wobwob73/mkii_wardriver/README.md

# mkii_wardriver
Fully fleshed out hardware-based wardriving system.
