wobwob73/mkii_wardriver/MKII_handoff/hardware_reference/canvas.png

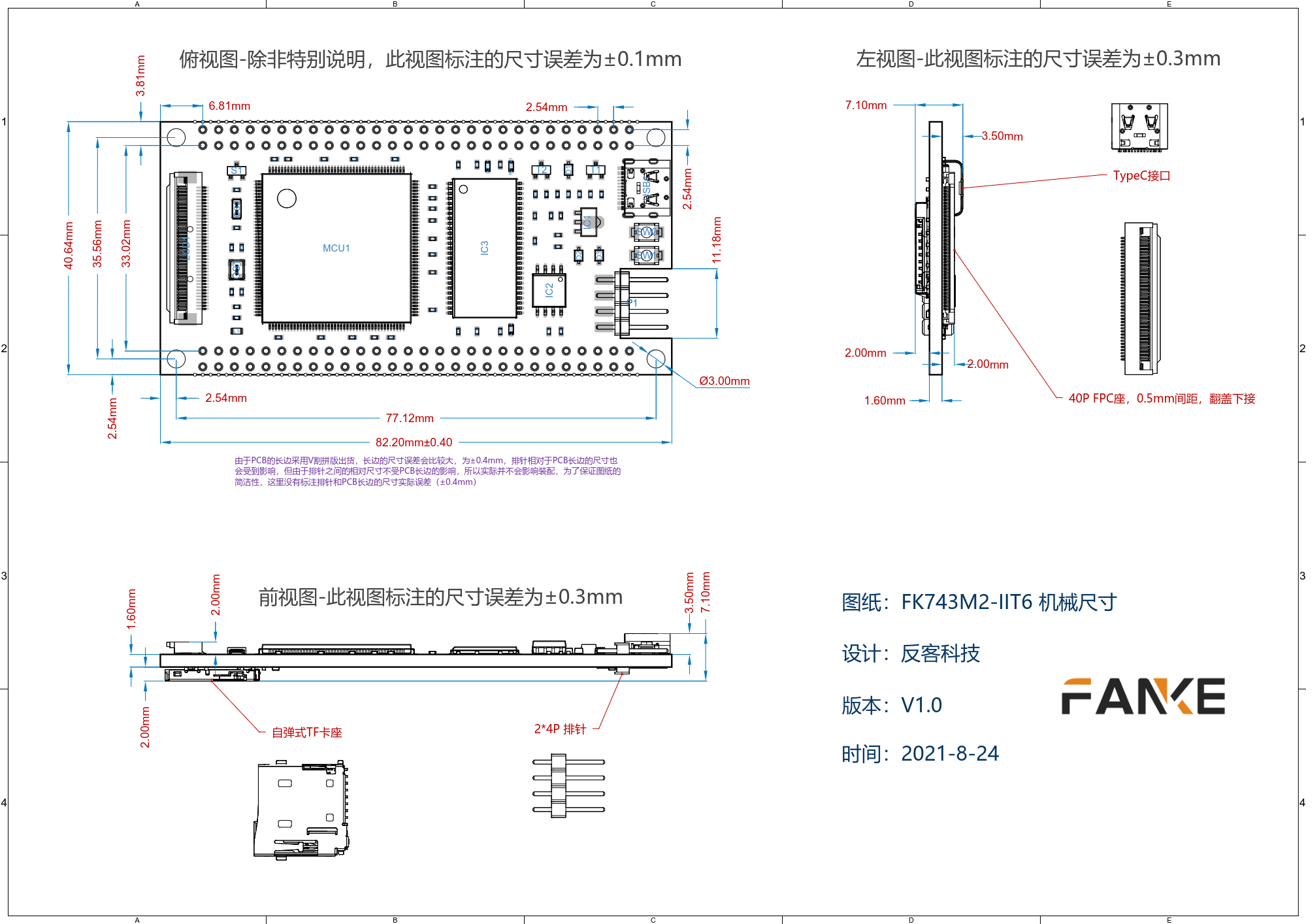
MKII_handoff/hardware_reference/canvas.png
