wobwob73/mkii_wardriver/firmware/agg_lite/src/pio_uart.h

#pragma once

#include "agg_defs.h"
#include "hardware/pio.h"

/* PIO software UART, reused verbatim from the WiFi BC (branch_wifi24). PIO0
 * SM0-SM2 carry the three Leaf RX links; a single PIO1 TX SM is retargeted per
 * send (F-001: PINCTRL OUT_BASE/SIDESET_BASE are updated and self-checked). */

typedef struct {
    PIO     pio;
    uint    sm;
    uint    rx_pin;
    int     dma_chan;
    uint32_t *ring;
    size_t  ring_words;
    volatile uint32_t read_pos;
} pio_uart_rx_t;

bool pio_uart_subsys_init(void);

bool pio_uart_rx_init(pio_uart_rx_t *u, uint pin, uint sm, uint32_t *ring, size_t ring_words);

int pio_uart_rx_read(pio_uart_rx_t *u, uint8_t *out, size_t cap);

void pio_uart_tx_send(uint pin, const uint8_t *bytes, size_t n);

void pio_uart_tx_send_line(uint pin, const char *line);

uint32_t pio_uart_tx_retarget_error_count(void);
