wobwob73/mkii_wardriver/(commit log)

2026-05-29 Add MKII handoff package (specs + docs)
    Extracted contents of 16523939-MKII_handoff.tar.gz as the project baseline:
    specs (system plan v2 + v2.1 amendment, WiFi24 leaf protocol v1.1, RP2040 BC
    guide v1.0, pre-MKII history), HANDOFF.md, CODE_STATUS.md, and FK743
    hardware reference (abandoned board, kept for lineage).
    No source code yet — the two prior firmware archives (leaf_wifi24,
    branch_wifi24) lived in an ephemeral sandbox and were not recoverable.
    Will be re-derived from the specs in subsequent commits.
2026-05-29 specs: add system_plan_v2_2_amendment (sensor-set reconciliation)
    Formalizes the SHT40 -> SCD41 + SGP41 change that HANDOFF.md flagged as
    stale in v2.1. Updates Sensor Branch §3.8 topology, sensor selection,
    core responsibilities, $EN (17 -> 20 fields, adds co2_ppm/voc_index/
    nox_index), $SB (replaces therm_ok with scd_ok + sgp_ok), failure
    handling, environment_records DDL, the Environment & Motion report row,
    and the cost estimate. Spec-first phase, item #1 from the roadmap.
2026-05-29 specs: add wifi24 BC firmware guide v1.1 amendment
    Resolves the four deviations CODE_STATUS.md flagged against BC v1.0:
    - §4.1 SPSC queues codified as true SPSC + __dmb() barriers (no
    spinlocks); §4.5 added with explicit producer/consumer pattern.
    - §6.3 dedup eviction switched from rehash-on-eviction to tombstone-
    based reclaim, with insert/lookup/compaction algorithms and a
    correctness sketch (fixes the double-increment bug).
    - §8.2 $RC relay now requires the embedded command's checksum to be
    re-verified before forwarding to a Leaf.
    - §12.1 PIO usage codified as PIO0 = 4× RX, PIO1 = 1× TX with OUT-pin
    remap per transmission; rationale documented.
    Also widens the `enc` fie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
2026-05-29 specs: add STM32 firmware guide v1.0 (NUCLEO-H753ZI)
    First-time spec for the STM32 mid-tier aggregator. Targets NUCLEO-
    H753ZI, supersedes the abandoned FK743M2-IIT6 design. Covers pin map
    for both STM32 units (single source tree via MKII_STM32_UNIT={1,2}
    flag), operating modes (standalone / connected / minimal), PPS edge
    capture + $TM emission within 100 ms, I2C GPS read (NMEA + UBX),
    Branch UART DMA RX + line dispatch, USB CDC streaming, $RC leaf_id
    routing, FatFS SD logging, module decomposition, state machine,
    memory budget, and bench-test procedure.
    Resolves HANDOFF.md §9 item 1 (STM32 board change). Spec-first phase,
    item #4 from the roadmap.
2026-05-29 specs: add Env Sensor Branch firmware guide v1.0 (RP2040)
    Single-board Branch (no Leaves). Covers I2C0 bus with ICM-42688-P,
    LIS3MDL, BMP390, SCD41, SGP41; dual-core split (Core 0 Madgwick AHRS
    @100 Hz, Core 1 slow sensors + output); per-sensor init/read details
    and conversions; SGP41 conditioning and SCD41-compensation chain;
    1PPS sync via the same pattern as the WiFi24 BC; $EN @10 Hz with the
    20-field v2.2 layout; $SB @0.1 Hz; module decomposition; memory
    budget; pico-sdk build config; bench-test procedure.
    Spec-first phase, item #5 from the roadmap.
2026-05-29 specs: add 5 GHz WiFi Branch v1.0 (Leaf protocol + BC firmware)
    Combined Leaf-protocol + BC-firmware doc for the 5 GHz WiFi Branch
    (ESP32-C5 ×2-3 + RP2040). Written as deltas against WiFi24 v1.1 + v1.2
    amendment and BC v1.0 + v1.1 amendment to avoid duplication; only the
    band-specific differences are restated. Covers the 5 GHz channel map
    (UNII-1/2A/2C/3), per-Leaf channel-set assignments, $CF channel_set_id
    table, 32-bit $CH bitmask split into lo/hi fields, $WA/$WP/$ET/$DF/$BS
    with branch_id W5G, ESP-IDF v5.x C5 specifics (passive scan, band
    selection), memory budget, and bench-test cadence expectations.
    Spec-first phase, item #6 from the roadmap.
2026-05-29 specs: add BLE/BT Branch v1.0 (Leaf protocol + BC firmware)
    Combined Leaf-protocol + BC-firmware doc for the BLE/BT Branch (2x
    ESP32-S3 + RP2040). BLE Leaf uses NimBLE with BLE 5 ext-adv + Coded
    PHY in BLE_SCAN_TYPE_PASSIVE; BT Classic Leaf uses Bluedroid in
    strict inquiry-scan mode (no active inquiry, per HANDOFF.md §1
    passive-only design). Defines $BL primary, $BX extended-payload
    follow-up, $BT BT Classic, $BK, and BC upstream $BD/$BX/$BC_T/$BS
    with branch_id BLE. Two dedup tables (5s BLE / 30s BT). Documents
    the listen-only caveats for BT Classic detection coverage. RPA
    resolution explicitly deferred to the analyzer.
    Spec-first phase, item #7 from the roadmap.
2026-05-29 specs: add 802.15.4 Branch v1.0 (Leaf protocol + BC firmware)
    Combined Leaf-protocol + BC-firmware doc for the 802.15.4 Branch
    (ESP32-H2 x2-4 + RP2040). Covers channels 11-26, ESP-IDF ieee802154
    component, promiscuous full-frame capture, MAC FCF parsing, addr-mode
    handling (short / extended), $ZD device records (14 fields incl. a
    proto_hint heuristic for Thread MLE / Zigbee NWK / Matter), $ZB beacon
    records with coordinator + SF spec + beacon payload, $CF with channel-
    set IDs 1-7, 16-bit $CH mask, BC dedup_dev (5s) + dedup_bcn (30s),
    $ZA / $ZN / $BS upstream with branch_id DOT. No WIDS path in v1.0.
    Spec-first phase, item #8 from the roadmap.
2026-05-29 specs: add Meshtastic/Meshcore Branch v1.0
    Combined Leaf-protocol + BC-firmware doc for the Meshtastic/Meshcore
    Branch (5x Heltec LoRa 32 V3 + RP2040 on STM32 #2 USART1). Extends
    the BC v1.1 PIO pattern: PIO0 holds 4 RX SMs, PIO1 hosts both the
    shared TX SM (SM0, OUT-pin remap) and a 5th RX SM (SM1). Per-Leaf
    default presets: MESH-1/2 US 915 (LongFast/MediumFast), MESH-3 EU 868,
    MESH-4 US 433, MCORE-1 915 Meshcore. SX1262 driven by RadioLib in
    listen-only continuous RX. $LR per packet with header_hex + proto_hint
    heuristic for Meshtastic / Meshcore / LoRaWAN / ELRS / Crossfire.
    BC dedups by (proto, node_id) over 60 s; $LA / $BS upstream with
    branch_id MTC. No intra-Leaf dedup (packets sparse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
2026-05-29 specs: add VHF ISM 315/433 MHz Branch v1.0
    Combined Leaf-protocol + BC-firmware doc for the VHF ISM Branch (6x
    Arduino Nano + superhet ASK RX modules + RP2040 on STM32 #2 USART2).
    Extends the BC PIO pattern further: PIO0 holds 4 RX SMs, PIO1 hosts
    the shared TX SM + 2 RX SMs = 6 Leaves total. Per-Leaf decoder
    profiles: 315-A/B Chamberlain/garage, 315-R generic ASK logger, 433-
    A/B rc-switch + Acurite + LaCrosse, 433-R generic. INT0-driven edge
    ring buffer (256 entries), rc-switch + custom decoders, repeat-count
    accumulator. $SG per detection w/ 11 fields incl. raw_code_hex,
    protocol_id heuristic, extra_hex for sensor payloads. BC dedups by
    (protocol_id, raw_code) across all Leaves over 5s; $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
2026-05-29 specs: add UHF ISM 868/915 MHz Branch v1.0
    Combined Leaf-protocol + BC-firmware doc for the UHF ISM Branch.
    Most heterogeneous Branch yet: 8 Leaves spanning HaLow (HT-HC33),
    LoRa (SX1262 x4), and FSK (CC1101 x3). First Branch to exceed PIO
    SM capacity - introduces the canonical 8-Leaf BC layout: PIO0 +
    PIO1 host 7 RX SMs + 1 TX SM, and the 8th Leaf is wired to RP2040
    hardware UART1 (PL011). Three upstream message types - $HA HaLow,
    $LR LoRa (extends Meshtastic's), $FS FSK with sync-word + proto_hint
    covering Z-Wave / Sidewalk / EnOcean / KNX-RF. UAS detection on
    UHF-915-UAS via ELRS-distinctive SF6/BW500 + SF9/BW500 LoRa combos.
    Three dedup tables (one per protocol family), $HW / $LA / $FA /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
2026-05-29 specs: add FPV Detection Branch v1.0
    Combined Leaf-protocol + BC-firmware doc for the FPV Detection Branch
    (2x Nano + RX5808 5.8 GHz scanners, 1x ESP32-S3 + SX1280 ELRS 2.4 GHz
    C2, 1x Nano + SX1262 legacy 433 C2, + RP2040 on STM32 #2 UART5). RX5808
    in SPI mode (RotorHazard-compatible) sweeping the full 48-channel FPV
    map (Boscam A/B/E + Fatshark + Raceband + Lowband). $FV per active
    channel; BC's agg_video tracks per-channel state with new/dropped/
    periodic events; $VA upstream surfaces channel activity + a uas_hint
    coincidence flag when FPV video + LoRa C2 co-occur (v1.0 coarse - real
    DOA correlation deferred). SX1280 ELRS preset rotation (SF5/BW800
    500Hz, SF5/BW400 250Hz, SF6/BW400 150Hz,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
2026-05-29 fw: re-derive leaf_wifi24 firmware (ESP32-C3, v1.2.0)
    Single-binary Leaf firmware for all four WiFi 2.4 GHz Leaves. Identity
    adopted from first $CF on UART0 (Branch Controller link). Implements
    wifi24_leaf_protocol v1.1 + v1.2 amendment:
    - enc enum 0-10 incl. LE_OWE (9) and LE_WPA3_ENT (10); SDK auth-mode
    mapping + RSN AKM walker with MFP-based WPA3-Ent disambiguation.
    - Passive scan @ ~200 ms/channel for W1-W3 ($AP + $BK per cycle).
    - WIDS promiscuous mode for W4: 14-channel hop, 100 ms dwell, ring
    buffer drop-newest on overflow, FNV-1a per-cycle BSSID dedup (512
    slots), $BC / $DE / $PR emission from main loop drain.
    - Standalone fallback after 10 s with no $CF (scan ch 1, leaf_id W?)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
2026-05-29 fw: re-derive branch_wifi24 firmware (RP2040, v1.1.0)
    WiFi 2.4 GHz Branch Controller firmware. Dual-core: Core 0 services
    four PIO0 RX state machines + line assembly + per-Leaf watchdog +
    downstream $CF/$CH/$PG/$RB; Core 1 owns 1PPS ISR + $TM ingest from
    STM32 UART0 + AP dedup + WIDS analysis + upstream $WA/$WP/$ET/$DF/$BS.
    Implements branch_controller_wifi24 v1.0 + v1.1 amendment:
    - True SPSC inter-core queues with __dmb() barriers, no spinlocks
    (queues.c).
    - PIO0 = 4 RX SMs loaded with uart_rx.pio; PIO1 = 1 TX SM with OUT-
    pin remap to address any of the four Leaves (pio_uart.c +
    uart_tx.pio).
    - Tombstone-based dedup eviction with linear-probe insert/lookup that
    records the first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
2026-05-29 ci: add GitHub Actions builds for leaf_wifi24 and branch_wifi24
    PlatformIO build for the ESP32-C3 Leaf firmware and pico-sdk + Ninja
    build for the RP2040 Branch Controller firmware. Both upload elf +
    bin/uf2 as workflow artifacts and key their caches off the
    platformio.ini / pico-sdk tag so subsequent runs are fast.
    Triggers on push and PR for changes under the respective firmware tree
    or the workflow file itself, plus manual workflow_dispatch. Adds the
    infrastructure called for in the spec-first phase's CI decision.
2026-05-29 fw(branch_wifi24): fix build - replace 'uint' with 'unsigned int'
    Local smoke build with pico-sdk 2.1.0 + arm-none-eabi-gcc 13.2.1
    revealed two issues in headers used by C compilation units:
    - 'uint' is a pico-sdk typedef in <pico/types.h>, not a standard C
    type. Header files (pps_time.h, leaf_cmd.h) used it in function
    signatures before pulling in the SDK header, so a compilation unit
    including just the local header before the SDK was including any
    pico-sdk header failed with 'unknown type name uint'. Switched to
    'unsigned int' which is the underlying definition.
    - main.c calls set_sys_clock_khz() which lives in hardware/clocks.h;
    the implicit-declaration warning is now resolve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
    [leaf_cmd.c, leaf_cmd.h, main.c, pps_time.c, pps_time.h]
2026-05-29 fw: add stm32_aggregator (App/ + PAL + Core/ scaffold)
    NUCLEO-H753ZI firmware. Single source tree, two unit images via
    -DMKII_STM32_UNIT={1,2} (unit 1 = WiFi24/W5G/BLE/DOT154/SEN on
    USART1/2/UART4/5/USART6; unit 2 = MTC/VHF/UHF/FPV on USART1/2/UART4/5).
    Structured around a Platform Abstraction Layer (Platform/Inc/pal.h)
    so the App/ business logic is portable C and the HAL specifics live
    in pal_hal.c. The PAL implementation is a stub - filling it in
    against CubeMX-generated HAL handles is described step-by-step in
    README.md "HAL bring-up".
    App/ modules (all spec-conformant per stm32_h753_firmware_v1_0.md):
    - proto: $..*XX\n framing + checksum + line receiver (shared shape
    with BC/Leaf pro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
2026-05-29 fw: add env_sensor_branch firmware (RP2040, v1.0.0)
    Single-board Branch (no Leaves). Implements env_sensor_branch_v1_0.md.
    Dual-core: Core 0 runs IMU @ 100 Hz + Madgwick AHRS + push to SPSC ring
    at 10 Hz; Core 1 services slow sensors (BMP390 @ 10 Hz, SCD41 @ 0.2 Hz,
    SGP41 @ ~1 Hz with conditioning), $TM ingest from STM32 UART0, $EN
    emission at 10 Hz with the v2.2-amended 20-field layout, $SB at 0.1 Hz.
    Sensor drivers (drop-in placement on shared I2C0 @ 400 kHz):
    - icm42688: WHO_AM_I check, ±8 g / ±2000 dps, INT1 push-pull pulsed,
    14-byte temp+accel+gyro burst read with SI conversion.
    - lis3mdl: WHO_AM_I check, ultra-high-perf XY/Z, ±4 gauss, continuous,
    6-byte XYZ read auto-increment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
2026-05-29 fw: add 5 GHz WiFi Branch (leaf_wifi5 + branch_wifi5)
    Implements wifi5_branch_v1_0.md.
    leaf_wifi5 (ESP32-C5, Arduino/PlatformIO, ~750 lines):
    - Single-binary, identity from first $CF on UART0. W5_1 / W5_2 / W5_3.
    - esp_wifi_set_band(WIFI_BAND_5G) at boot for both scan and WIDS paths.
    - $CF carries (mode, channel_set_id, dwell_ms): channel_set_id 1-7 maps
    to UNII band combinations per the spec. Default per-Leaf assignments:
    W5_1 csid=3 (UNII-1+2A), W5_2 csid=6 (UNII-2C+3), W5_3 csid=7 (all).
    - Scan path hops across the channel-set list with passive scan ~200 ms/
    channel; emits $AP + $BK each batch (sweep times ~1.6 s / 3.4 s / -).
    - WIDS path identical to leaf_wifi24's $BC/$DE/$PR + ri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
2026-05-29 fw(leaf_wifi5): switch to pioarduino platform for ESP32-C5 support
    CI run 26661010736 failed leaf_wifi5 at ~16 s — mainline PlatformIO
    espressif32@^6.9.0 doesn't recognize esp32-c5-devkitc-1 yet (the
    platform tracks arduino-esp32 with a multi-month lag; C5 support
    reached arduino-esp32 in 3.1.x but hasn't propagated to the registry
    package this firmware was pinned to).
    pioarduino is the community-maintained PlatformIO platform fork that
    ships current arduino-esp32 releases — including a board file for
    esp32-c5-devkitc-1 and arduino-esp32 v3.x. Pinning to a specific
    release (54.03.21) keeps the build reproducible.
    Addresses wifi5_branch_v1_0.md Open Item #2.
2026-05-29 fw(leaf_wifi5): correct pioarduino platform URL (tag 55.03.38-1)
    The previous attempt pointed at a release-asset zip URL that doesn't
    exist - pioarduino's tag scheme is 55.03.xx (not 54.03.xx) and the
    release asset filename varies per release.
    Switching to PlatformIO's git+tag URL form which resolves to the
    tagged commit and always works for any pioarduino release. Pinned to
    55.03.38-1, the latest stable as of this commit, which ships
    arduino-esp32 v3.3.x and includes an esp32-c5-devkitc-1 board file.
    Re-kicks CI run that failed on 1414303 with the same "build" error.
2026-05-30 fw(stm32): add HAL bring-up scaffold (Core/ + HAL-backed PAL)
    Hand-coded CubeMX-equivalent for the NUCLEO-H753ZI on-target build.
    Host-smoke build is unchanged (Platform/Src/pal_hal.c stays as stub);
    the on-target CMake target (added in a follow-up commit) compiles the
    new files instead.
    Added files:
    - Core/Inc/main.h: pin map (USART1/2/3/4/5/6/7, I2C1, SDMMC1, USB,
    EXTI10, LEDs, button), HAL handle externs, Branch RX ring decls.
    - Core/Inc/stm32h7xx_hal_conf.h: HAL module enables, HSE = 8 MHz from
    ST-LINK MCO bypass, voltage scale 0 (480 MHz), full HAL includes.
    - Core/Src/main.c: SystemClock_Config to 480/240/100 MHz, MX_*_Init
    for each peripheral, DMA RX circular start for the 4-5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
2026-05-30 fw(stm32): add on-target build — flashable .elf for both units
    Completes the STM32 firmware to a flashable image. The CMake
    on-target target (MKII_STM32_TARGET=on with the ARM bare-metal
    toolchain file) fetches STM32CubeH7 v1.11.2 via FetchContent, inits
    the HAL Drivers + CMSIS device submodules, builds the App/ + Core/ +
    Platform/ tree against the HAL, and produces stm32_aggregator_unit{1,
    2}.{elf,bin,hex} (~82 KB each).
    Added:
    - Platform/USB/Inc, Platform/USB/Src: USB CDC class glue
    (usb_device, usbd_conf, usbd_desc, usbd_cdc_if). FS speed, vendor
    0x1209, product 0x4D49 placeholder, per-unit serial string. Vendor
    hpcd PCD callbacks bridge to USBD core; CDC_Receive_FS pushes
    inbo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
2026-06-01 fw+docs: stabilize firmware trees; fix confirmed defects; truth-up handoff
    Stabilization pass across the existing firmware. No new branch firmware.
    Fixes confirmed defects, resolves two open decisions, and regenerates the
    status docs to match the repo. Verified by builds where the toolchain is
    reachable; the one network-gated build is documented.
    leaf_wifi5 — 5 GHz band-select bug (fixed; FW 1.0.0 -> 1.0.1)
    wifi_scan.cpp / wids_monitor.cpp guarded esp_wifi_set_band(WIFI_BAND_5G)
    with #ifdef WIFI_BAND_5G. WIFI_BAND_5G is an esp-idf wifi_band_t
    enumerator, not a macro, so the guard was always false and the call was
    compiled out — the C5 never left 2.4 GHz. Guards now use #ifdef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
    [leaf_defs.h, main.c, pal_hal.c, stm32_config.h, wids_monitor.cpp, wifi_scan.cpp]
2026-06-02 fw+specs: address external code review (mkii_code_analysis_report.md)
    Confirmed defects from the 2026-06-01 review fixed before any bring-up.
    No new branch firmware. Shared patterns fixed in place so the remaining
    six branches inherit a correct template.
    CRITICAL fixes
    F-001 — PIO TX retarget actually retargets (branch_wifi24, branch_wifi5).
    Old uart_tx_program_retarget_pin() only re-pinned the GPIO and never
    updated PINCTRL.OUT_BASE / SIDESET_BASE — every downstream byte left
    on the first leaf's TX pin, so W2..W4 / W5_2..W5_3 silently never
    received their $CF. New uart_tx_retarget_pin() in pio_uart.c:
    1. drain FIFO + 80 µs settle for the in-flight character;
    2. disabl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
    [branch_defs.h, cmd_router.c, core1_upstream.c, env_defs.h, gps.c, leaf_defs.h, pal_hal_stm32h7.c, pio_uart.c]
2026-06-02 fw(leaves): validate $CF mode at the boundary (review #4 pulled forward)
    Pull-forward of the second external review's finding #4 — the one item
    whose risk profile actually changed because of the previous push (F-001).
    Before F-001's PIO TX retarget fix, $CF to W2..W4 / W5_2..W5_3 wasn't
    reaching them; an unvalidated mode byte couldn't put a leaf into an
    unexpected state. With F-001 landed, $CF now reaches every leaf, and a
    corrupt mode byte (or a future $CF extension adding a value not yet
    enumerated) could flip a leaf into WIDS mode unexpectedly.
    Fix
    Reject mode values outside the declared LeafMode enum at the
    adopt_from_cf() boundary in both leaf trees. The existing
    hb::note_error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
    [config.cpp, leaf_defs.h]
2026-06-02 Add agg_lite light-duty aggregator, leaf_ble, and WiFi24 Scan-Hop (v1.3)
    Adds a single-box "lite" variant of the MKII aggregator for fixed-position
    use, plus the Leaf-side prerequisites it consumes, tied into the existing
    firmware/ trees and CI.
    firmware/agg_lite (NEW, RP2040, lite_aggregator_v1_0.md):
    - One RP2040 plays the Branch-Controller role for three families (2.4 GHz
    scan-hop, 5 GHz scan, BLE) and the STM32 role (own GPS, own 1PPS+$TM, SD).
    - Core 0: 3 PIO UART Leaf links, line assembly, per-family dispatch, health
    watchdog, downstream $CF/$CH/$PG/$RB. Core 1: GPS NMEA (UART1, F-003),
    1PPS + locally generated $TM (F-004 atomic snapshot), three dedup pipelines
    (WiFi re-entran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
    [agg_defs.h, agg_state.c, agg_state.h, ble_defs.h, ble_scan.c, ble_scan.h, cmd_handler.cpp, config.c]
2026-06-02 fw(leaf_ble): bound $BX fields so the framed line fits MAX_LINE_LEN
    ESP-IDF builds the component with -Werror=format-truncation, which caught a
    real defect: emit_bx() could produce a $BX line up to ~218 bytes, past the
    200-byte protocol limit (MAX_LINE_LEN). A longer line is truncated and its
    XOR checksum no longer matches, so the receiver drops it.
    Bound each field to its blebt_branch_v1_0.md §4.2 size: manufacturer data
    <=30 bytes (<=60 hex), service-UUID list capped at 16 bytes, and name_full_hex
    now carries only the bytes BEYOND the 16 already sent in $BL (per the spec,
    "Full local name beyond 16 bytes") instead of the whole name. Worst-case body
    is now ~154 bytes, well inside the limi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
    [main.c]
2026-06-02 fw(leaf_ble): bound combined $BX so the upstream record fits MAX_LINE_LEN
    The binding line is the aggregator/BC $BX, which prepends branch_id +
    timestamp + time_flag (~49 B) to the leaf's three variable fields. The prior
    per-field caps (60+32+32 hex) made the leaf line fit but pushed the upstream
    $BX to ~206 B, past MAX_LINE_LEN — where send_framed would drop it. The leaf
    also capped svc below what it had stored, silently dropping UUIDs.
    Cap the COMBINED manuf + svc + name hex to <=140 (manuf <=30 B, svc <=24 B on
    whole 2-byte UUID boundaries, name <=16 B beyond the 16 already in $BL), so the
    upstream $BX body is <=189 B and the line stays within MAX_LINE_LEN with a
    valid checksum. Any tr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
    [ble_defs.h, ble_scan.c, main.c]
2026-06-02 agg_lite: vendor FatFs-over-SPI library and implement the real SD backend
    Retires the SD placeholder as the durable path. Adds a real microSD backend
    behind the unchanged sd_spi_fatfs.h interface, selected with
    -DAGG_SD_BACKEND=fatfs; the stub stays selectable (default) for host/CI without
    a card.
    Vendoring (third_party/pico_fatfs_spi/):
    - carlk3 no-OS-FatFS-SD-SPI-RPi-Pico, pinned commit
    196016f525e5b9c161f2b965ddd3045a4ef87649 (master), Apache-2.0.
    - Vendored verbatim (FatFs_SPI/ library subtree + LICENSE); provenance in
    VENDOR.md. Tree unmodified; the FatFs ffconf.h is used as shipped
    (FF_FS_MINIMIZE=0 gives f_mkdir/f_rename; FF_USE_LFN=3 gives the 15-char
    YYYYMMDD_HHMMSS session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
2026-06-02 fw(agg_lite): fix premature comment close in sd_hw_config.c
    The header comment contained the glob "spi_get_*/sd_get_*", whose "*/" closed
    the block comment early, so the rest of the comment was parsed as C and the
    fatfs build failed (unknown type 'sd_get_', cascading int8_t errors). Reworded
    to remove the "*/" sequence. The vendored FatFs library and the real backend
    (sd_spi_fatfs.c) compiled fine; only this comment was at fault.
    https://claude.ai/code/session_01Fjuy4NfjJUpCQ34gpywTtY
    [sd_hw_config.c]
2026-06-02 fw(agg_lite): initialize USB CDC on core 0 so the device enumerates
    The SDK drives tud_task() from a repeating timer on the default alarm pool
    (created on core 0), but the servicing IRQ is enabled on whichever core calls
    stdio_usb_init(). usb_cdc_mirror_init() ran on core 1, splitting the timer and
    the IRQ across cores, so the task never ran and the CDC device never
    enumerated -- the board ran and the LED blinked, but no /dev/ttyACM appeared.
    Move stdio_usb_init() to main() on core 0, immediately before the core1
    launch, co-locating the timer and the IRQ. usb_cdc_mirror_init() is now a
    no-op; usb_cdc_mirror_connected()/_write() are unchanged. No CMake change
    (pico_enable_stdio_usb + pico_st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
2026-06-02 fw: bring-up fixes — BLE UART D0/D1, C5 8MB flash, volatile++ , platform pin, doc sync
    Bench bring-up follow-ups (item 1, USB-on-core-0, already landed in a prior
    commit).
    Functional:
    - leaf_ble: default BC-link UART pins -> XIAO ESP32-S3 header pads D0/D1
    (LEAF_UART_TX_PIN=1 / RX_PIN=2); GPIO17/18 are not broken out on that board.
    - leaf_wifi5 + leaf_wifi24: replace `g_dropped++` (a volatile) with
    `g_dropped = g_dropped + 1` in wids_monitor.cpp — ++ on a volatile is
    deprecated in C++20 (-Wvolatile), a hard error on a future toolchain. Both
    leaves share the pattern, so both are fixed.
    - leaf_wifi5: XIAO C5 is 8 MB but the esp32-c5-devkitc-1 board file assumes
    4 MB, leaving the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
    [ble_defs.h, wids_monitor.cpp]
2026-06-03 fw(agg_lite): make SD card-detect optional, default off (CD-less SPI adapter)
    The chosen microSD hardware is a 6-pin SPI breakout (CLK/MOSI/MISO/CS + power)
    with no card-detect line. With use_card_detect=true and no CD wire, GP22 floats
    high, the driver reports "no card", sd_be_present() is false, and fatfs logging
    silently no-ops (bench worked around it by shorting GP22 to GND).
    Gate it behind a build flag, default off:
    - agg_defs.h: add AGG_SD_CARD_DETECT (default 0).
    - sd_hw_config.c: .use_card_detect = (AGG_SD_CARD_DETECT != 0). When 0 the FatFs
    driver skips CD polling and assumes the card is present, gating on mount
    success (correct for a CD-less adapter) and freeing GP22. Build wi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
    [agg_defs.h, sd_hw_config.c]
